Lord-ZuzurNC/Air-mes-Remote-Agent/models/case/solidcraft_back_v06_final.step

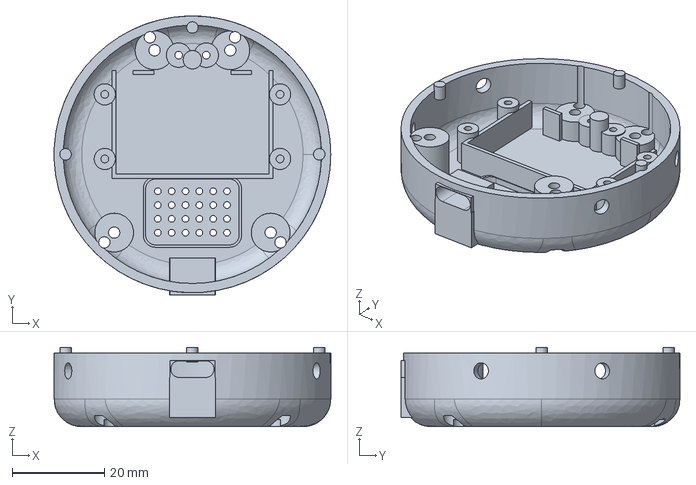
[picture p1: CAD file, 2026-11-14]
models/case/solidcraft_back_v06_final.step
60.0 x 60.5 x 17.2 mm
