Lord-ZuzurNC/Air-mes-Remote-Agent/models/pcb/ara_pcb_floorplan.stl

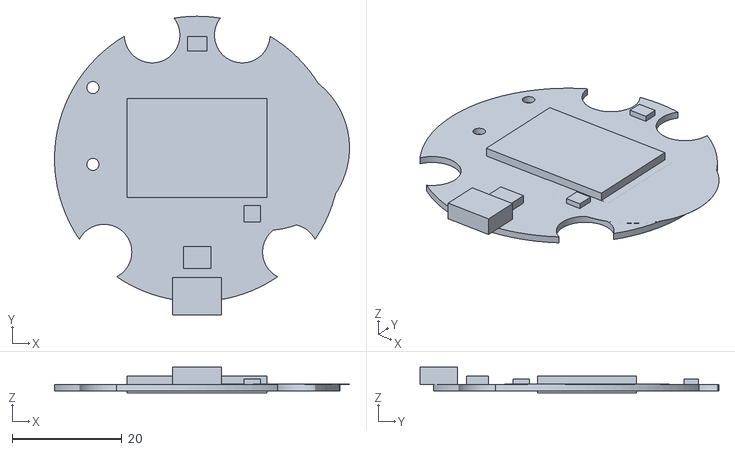
[picture p2: CAD file, 2026-11-12]
models/pcb/ara_pcb_floorplan.stl
53.8 x 54.4 x 4.71
