Lord-ZuzurNC/Air-mes-Remote-Agent/models/case/ara_v05_front.stl

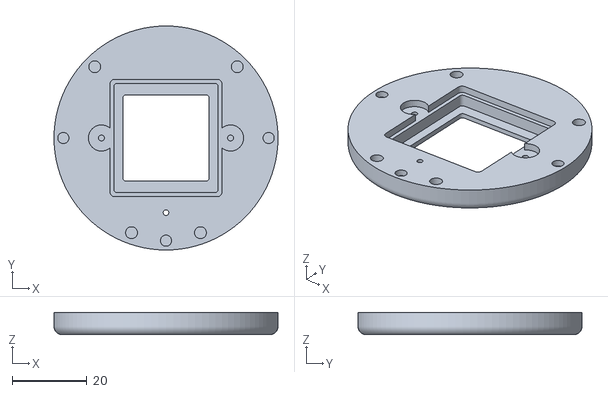
[picture p3: CAD file, 2026-11-13]
models/case/ara_v05_front.stl
60.0 x 60.0 x 6.00
