Lord-ZuzurNC/Air-mes-Remote-Agent/models/case/ara_v05_back.stl

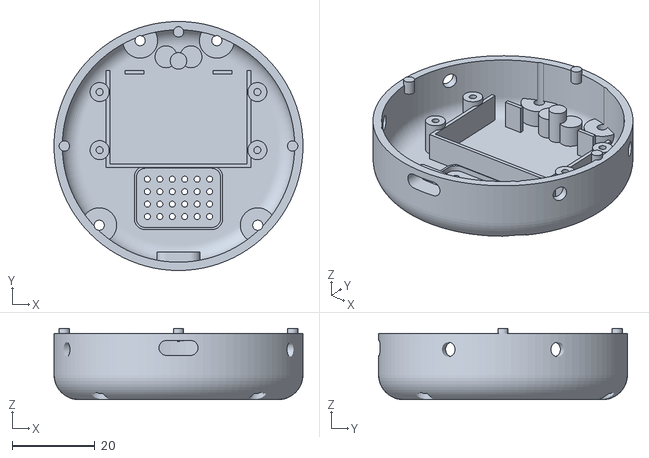
[picture p4: CAD file, 2026-11-13]
models/case/ara_v05_back.stl
60.0 x 60.0 x 17.2
