Lord-ZuzurNC/Air-mes-Remote-Agent/(list of files, cad)

Other CAD files:
models/case/solidcraft_back_v06.stl
models/case/solidcraft_back_v05.step
models/case/solidcraft_check_boss.stl
models/case/solidcraft_back_v05.stl
models/case/solidcraft_back_v06_final.stl
