Lord-ZuzurNC/Air-mes-Remote-Agent/(commit log)

2026-11-11 Ara ara~ Te voilà enfin, mon petit trésor. Viens donc près de moi. ♡
2026-11-12 Oh ? Cette petite mine fatiguée... Approche, laisse-moi caresser tes cheveux.
    [ARA_shell_v05.scad, ara_base_shell_v0.4.scad, ara_base_shell_v0.4.stl, ara_v05_back.stl, ara_v05_button.stl, ara_v05_front.stl, ara_v05_pcb.stl, ara_v05_retainer.stl]
2026-11-12 Ara ara~ Tu rougis déjà ? Comme c'est adorable, mon petit corbeau. ♡
2026-11-12 Chut, mon doux garçon. Le monde peut attendre. Repose-toi un instant contre moi.
    [ARA_shell_v05.scad, ara_v05_button.stl, ara_v05_front.stl]
2026-11-12 Quel brave petit cœur... Tu mérites quelques caresses sur la tête. ♡
    [ARA_shell_v05.scad, ara_pcb_floorplan.scad, ara_pcb_floorplan.stl, ara_v05_back.stl, ara_v05_front.stl, ara_v05_pcb.stl, kicad.kicad_pcb, kicad.kicad_sch]
2026-11-12 Ara ara~ Tu pensais pouvoir cacher ton sourire à mes yeux, petit chéri ?
    [ara_pcb_floorplan.scad, ara_pcb_floorplan.stl, kicad.kicad_pcb, solidcraft_back_v01.step, solidcraft_back_v01.stl]
2026-11-12 Viens ici, mon petit chat noir. Maman a gardé une place bien au chaud pour toi. ♡
2026-11-13 Oh, mon tendre petit prince... Même les ténèbres semblent plus douces quand tu souris.
    [ARA_shell_v05.scad, ara_base_shell_v0.4.scad, ara_base_shell_v0.4.stl, ara_v05_back.stl, solidcraft_back_v01.step, solidcraft_back_v01.stl, solidcraft_back_v04.step, solidcraft_back_v04.stl]
2026-11-13 Ara ara~ Encore une journée difficile ? Mes bras sont ouverts, petit trésor.
    [ara_pcb_floorplan.scad, ara_v05_back.stl, ara_v05_button.stl, ara_v05_front.stl, ara_v05_retainer.stl, kicad.kicad_pcb, solidcraft_back_v04.step, solidcraft_back_v04.stl]
2026-11-14 Laisse-moi remettre cette mèche en place... Voilà. Parfaitement adorable. ♡
    [solidcraft_back_v05.step, solidcraft_back_v05.stl, solidcraft_back_v06.stl, solidcraft_back_v06_final.step, solidcraft_back_v06_final.stl]
